Monash-BoSL/BoSL-nano/README.md

# micro-BoSL
A micro version of the BoSL board
