Monash-BoSL/BoSL-nano/Program-Conn/Program Connector BOM Rev 0.1.0.xlsx

Part Number | Package Size / Type | Schematic Designator | Component | Value | QTY per board | Unit Price | Total Price | Supplier
 |  | J1 | 0.1" Pin Socket | 02x03 | 1 | $0.10 | $0.10
2430 |  | J2 | Pogo Pins |  | 6 | $0.49 | $2.97 | https://au.mouser.com/ProductDetail/Adafruit/2430/?qs=GURawfaeGuDsBQlXUxEF%252BA==
 |  |  | PCB | 0.8 mm Thinkness
