Monash-BoSL/BoSL-nano/nano/EDA/BoSLnano BOM Rev 0.1.0.xlsx

Part Number | Package Size / Type | Schematic Designator | Component | Value | QTY per board | Unit Price | Total Price | Supplier
146236-0011 |  | AE1 | NFC Antenna |  | 1 | $1.25 | $1.25 | https://au.mouser.com/ProductDetail/Molex/146236-0011/?qs=5aG0NVq1C4xhVsWJeZnAXw==
2337019-1 |  | AT1, AT2 | U.FL Antenna Connector |  | 2 | $0.34 | $0.68 | https://au.mouser.com/ProductDetail/TE-Connectivity/2337019-1
EMZR160ARA101ME61G | SMD:CP_Elec_5x5.8 | C1 | SMD Capacitor | 100 uF | 1 | $0.93 | $0.93 | https://au.mouser.com/ProductDetail/United-Chemi-Con/EMZR160ARA101ME61G?qs=y6ZabgHbY%252BxiK8n17fhUqw==
Any Applicable | 0805 | C2 | SMD Capacitor | 10 uF | 1 | $0.16 | $0.16 | https://au.mouser.com/ProductDetail/Samsung-Electro-Mechanics/CL21A106KPFNNNG/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
Any Applicable | 0402 | C3, C6, C7, C9, C10, C11, C12, C15, C18 | SMD Capacitor | 100 nF | 9 | $0.10 | $0.90
Any Applicable | 0402 | C4,C5,C13,C16 | SMD Capacitor | 15 pF | 4 | $0.10 | $0.40
Any Applicable | 0402 | C8,C14 | SMD Capacitor | 1 uF | 2 | $0.10 | $0.20
Any Applicable | 0402 | C17 | SMD Capacitor | 220 pF | 1 | $0.10 | $0.10
Any Applicable | 0402 | C19 | SMD Capacitor | 1 nF | 1 | $0.10 | $0.10
PMEG2005EL,315 | SOD882 | D1 | Schottky Diode |  | 1 | $0.46 | $0.46 | https://au.mouser.com/ProductDetail/Nexperia/PMEG2005EL315?qs=LOCUfHb8d9uUSLf2%252Btg0Cg==
Any Applicable | 0603 | D2 | SMD LED | BLUE | 1 | $0.10 | $0.10
Any Applicable | 0603 | D3 | SMD LED | RED | 1 | $0.10 | $0.10
Any Applicable | 0603 | D4 | SMD LED | YELLOW | 1 | $0.10 | $0.10
Any Applicable | 0603 | D5 | SMD LED | GREEN | 1 | $0.10 | $0.10
104031-0811 Molex |  | J1 | microSD connector |  | 1 | $2.50 | $2.50 | https://au.mouser.com/ProductDetail/Molex/104031-0811?qs=sGAEpiMZZMuJakaoiLiBpj1mGp1aVlb8QxJnovvyiw8%3D
S2B-PH-SM4-TB(LF)(SN) | JST PH | J8 | Power Connector | 2 pin | 1 | $0.98 | $0.98 | https://au.element14.com/jst-japan-solderless-terminals/s2b-ph-sm4-tb-lf-sn/connector-header-smt-r-a-2mm-2way/dp/9492615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
SIM Card Holder | Nano SIM | J9 | SIM Card Holder |  | 1 | $1.50 | $1.50 | https://au.mouser.com/ProductDetail/Molex/104224-0820
105133-0001 | Micro | J10 | Micro USB Connector | Vertical | 1 | $1.46 | $1.46 | https://au.element14.com/molex/105133-0001/usb-conn-2-0-micro-usb-type-b/dp/2751682?st=micro usb
MLG0603P9N1HT000 | 0603 | L1 | Inductor | 9.1 nH | 1 | $0.15 | $0.15 | https://au.mouser.com/ProductDetail/TDK/MLG0603P9N1HT000/?qs=u4%252BEJ9urDAQc/lR37YK7mA==
Any Applicable | 0402 | R1,R2 | SMD Resistor | 1 kΩ | 2 | $0.10 | $0.20
Any Applicable | 0402 | R3,R5,R6 | SMD Resistor | 39 Ω | 3 | $0.10 | $0.30
Any Applicable | 0402 | R4 | SMD Resistor | 100 kΩ | 1 | $0.10 | $0.10
Any Applicable | 0402 | R7, R8, R12, R17 | SMD Resistor | 10 kΩ | 4 | $0.10 | $0.40
Any Applicable | 0402 | R9, R14, R15, R16 | SMD Resistor | 3.3 kΩ | 4 | $0.10 | $0.40
Any Applicable | 0402 | R10 | SMD Resistor | 12 MΩ | 1 | $0.10 | $0.10
Any Applicable | 0402 | R11 | SMD Resistor | 3.3 MΩ | 1 | $0.10 | $0.10
Any Applicable | 0402 | R13 | SMD Resistor | 18 kΩ | 1 | $0.10 | $0.10
SKTHAHE010 |  | SW1 | Tactile Switch |  | 1 | $0.87 | $0.87 | https://au.mouser.com/ProductDetail/Alps-Alpine/SKTHAHE010/?qs=T3oQrply3y8NYoSxPHM%252Buw==
MAX40203ANS | WLP-4 | U1,U2 | Ideal Diode |  | 2 | $0.93 | $1.86 | https://au.mouser.com/ProductDetail/Maxim-Integrated/MAX40203ANS%2bT
MCP1700T-3302E/TT | SOT-23 | U3 | Voltage Regulator |  | 1 | $0.54 | $0.54 | https://au.mouser.com/ProductDetail/Microchip-Technology/MCP1700T-3302E-TT/?qs=fM4xO01eazPmCNDrdHEdaw==
SAMD21G18A-MUT | QFN-48 | U4 | MCU |  | 1 | $4.44 | $4.44 | https://au.mouser.com/ProductDetail/Microchip-Technology-Atmel/ATSAMD21G18A-MUT/
NT3H2111W0FTTJ | TSSOP-8 | U5 | NFC Controller |  | 1 | $1.28 | $1.28 | https://au.mouser.com/ProductDetail/NXP-Semiconductors/NT3H2111W0FTTJ/?qs=5ptrxOxu%252BRZcycowRVRRqw==
nRF9160-SICA | SiP | U6 | LTE Modem |  | 1 | $33.80 | $33.80 | https://au.mouser.com/ProductDetail/Nordic-Semiconductor/nRF9160-SICA-R/?qs=PqoDHHvF648umA0p6bFBjQ==
BGA524N6E6327XTSA1 | TSNP-6 | U7 | GNSS LNA |  | 1 | $1.02 | $1.02 | https://au.mouser.com/ProductDetail/Infineon-Technologies/BGA524N6E6327XTSA1
MSQA6V1W5T2G | SOT-353 | U8 | ESD Protection Diodes |  | 1 | $0.54 | $0.54 | https://au.mouser.com/ProductDetail/ON-Semiconductor/MSQA6V1W5T2G/
FC-135 32.7680KA-AG5 |  | Y1 | Crystal | 32.768kHz | 1 | $0.43 | $0.43 | https://www.digikey.com.au/product-detail/en/epson/FC-135-32-7680KA-AG5/SER4271CT-ND/7932258
