Monash-BoSL/BoSL-nano/nano/EDA/BoSLnano Schematic rev0.1.0.pdf

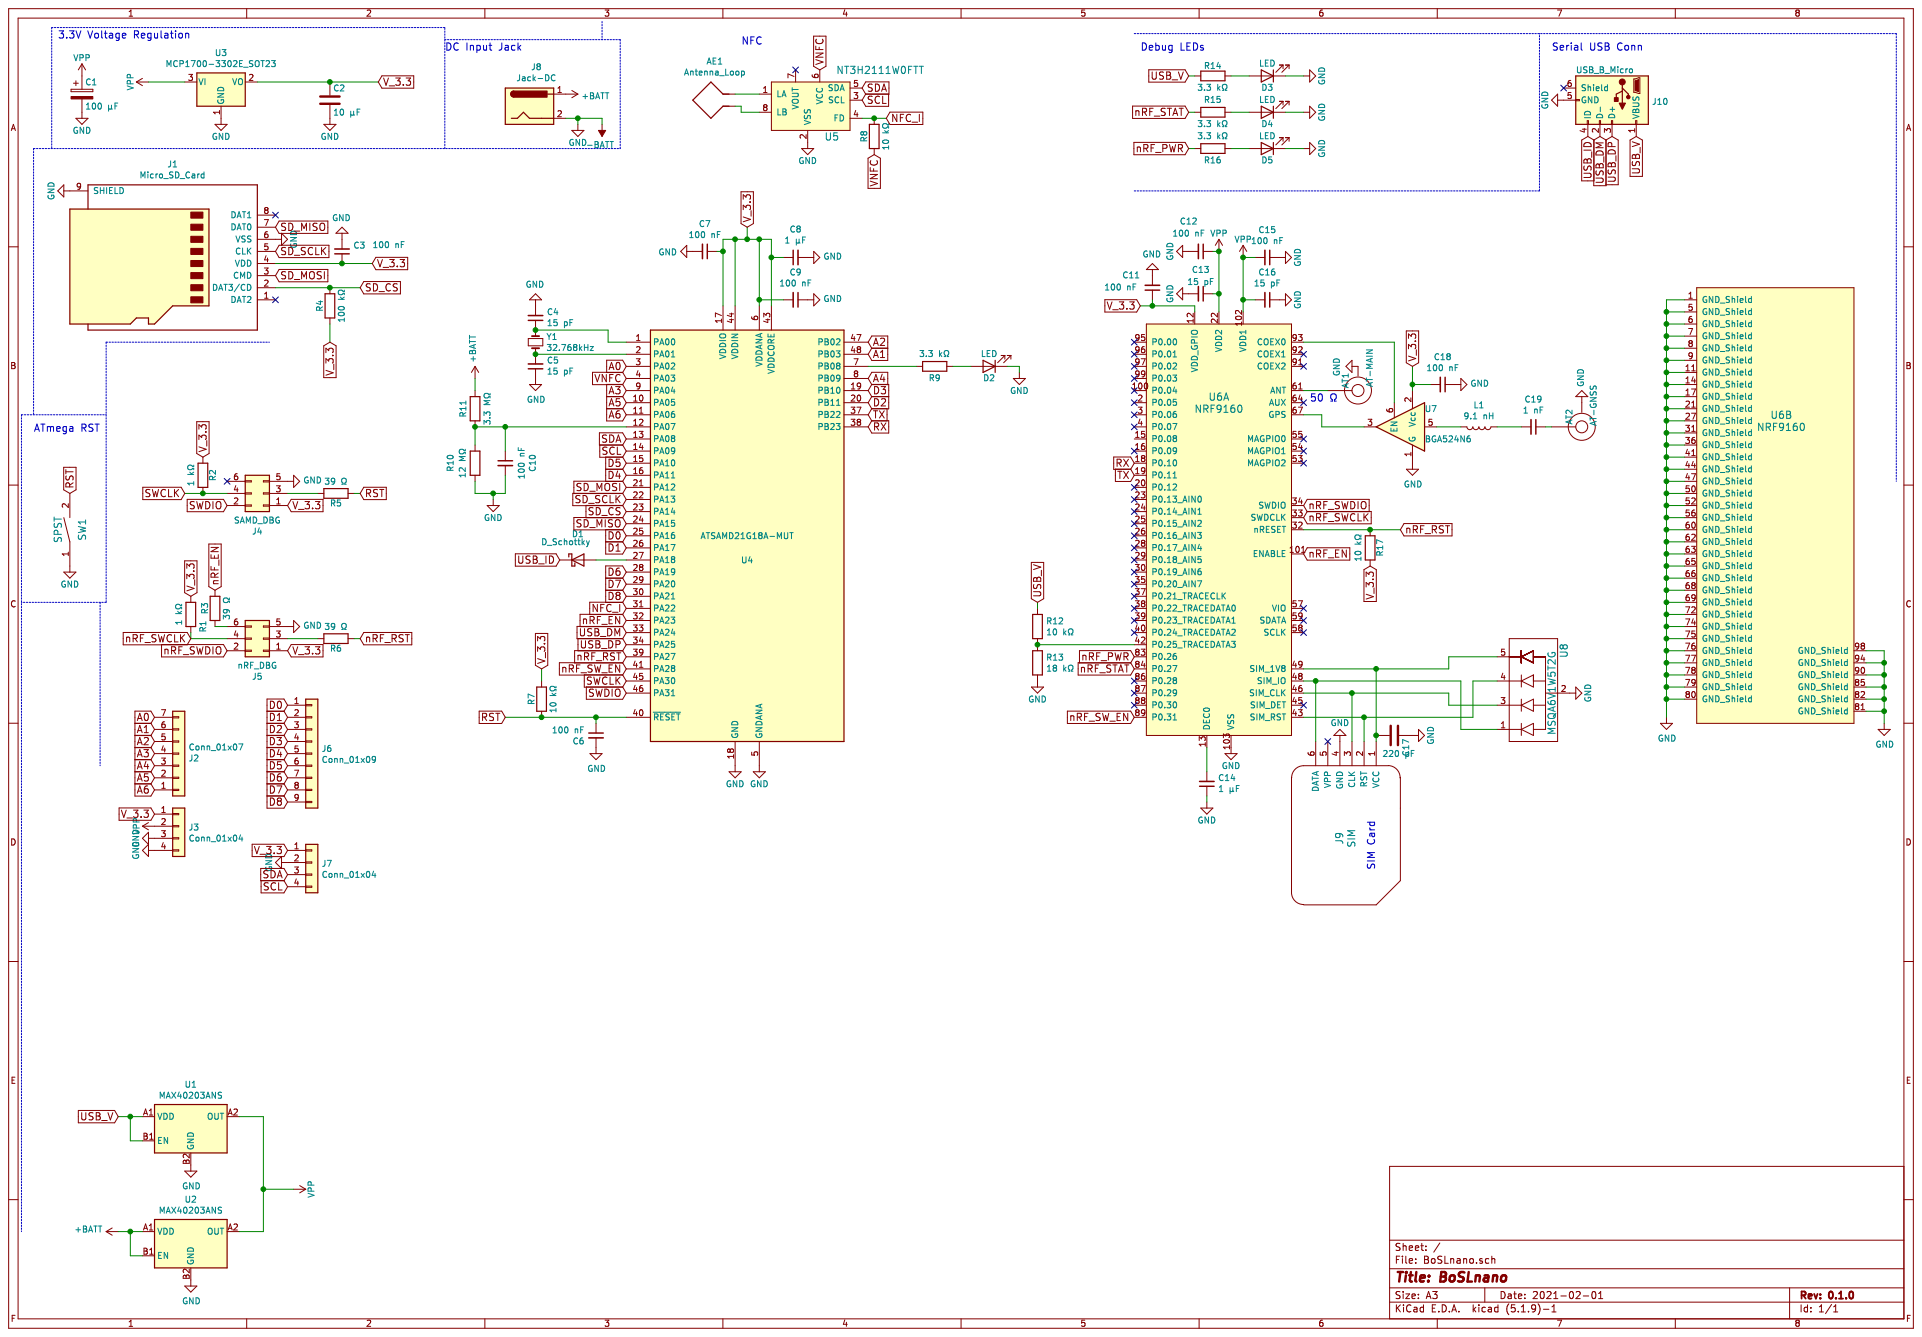
[picture p1: page 1]
