Monash-BoSL/BoSL-nano/(list of files, drawings)

Other design files:
nano/EDA/EDA/BoSLnano.dsn
