Monash-BoSL/BoSL-nano/nano/EDA/EDA/BoSLnano.kicad_pcb

## KiCad design nano/EDA/EDA/BoSLnano.kicad_pcb (2021-02-01)

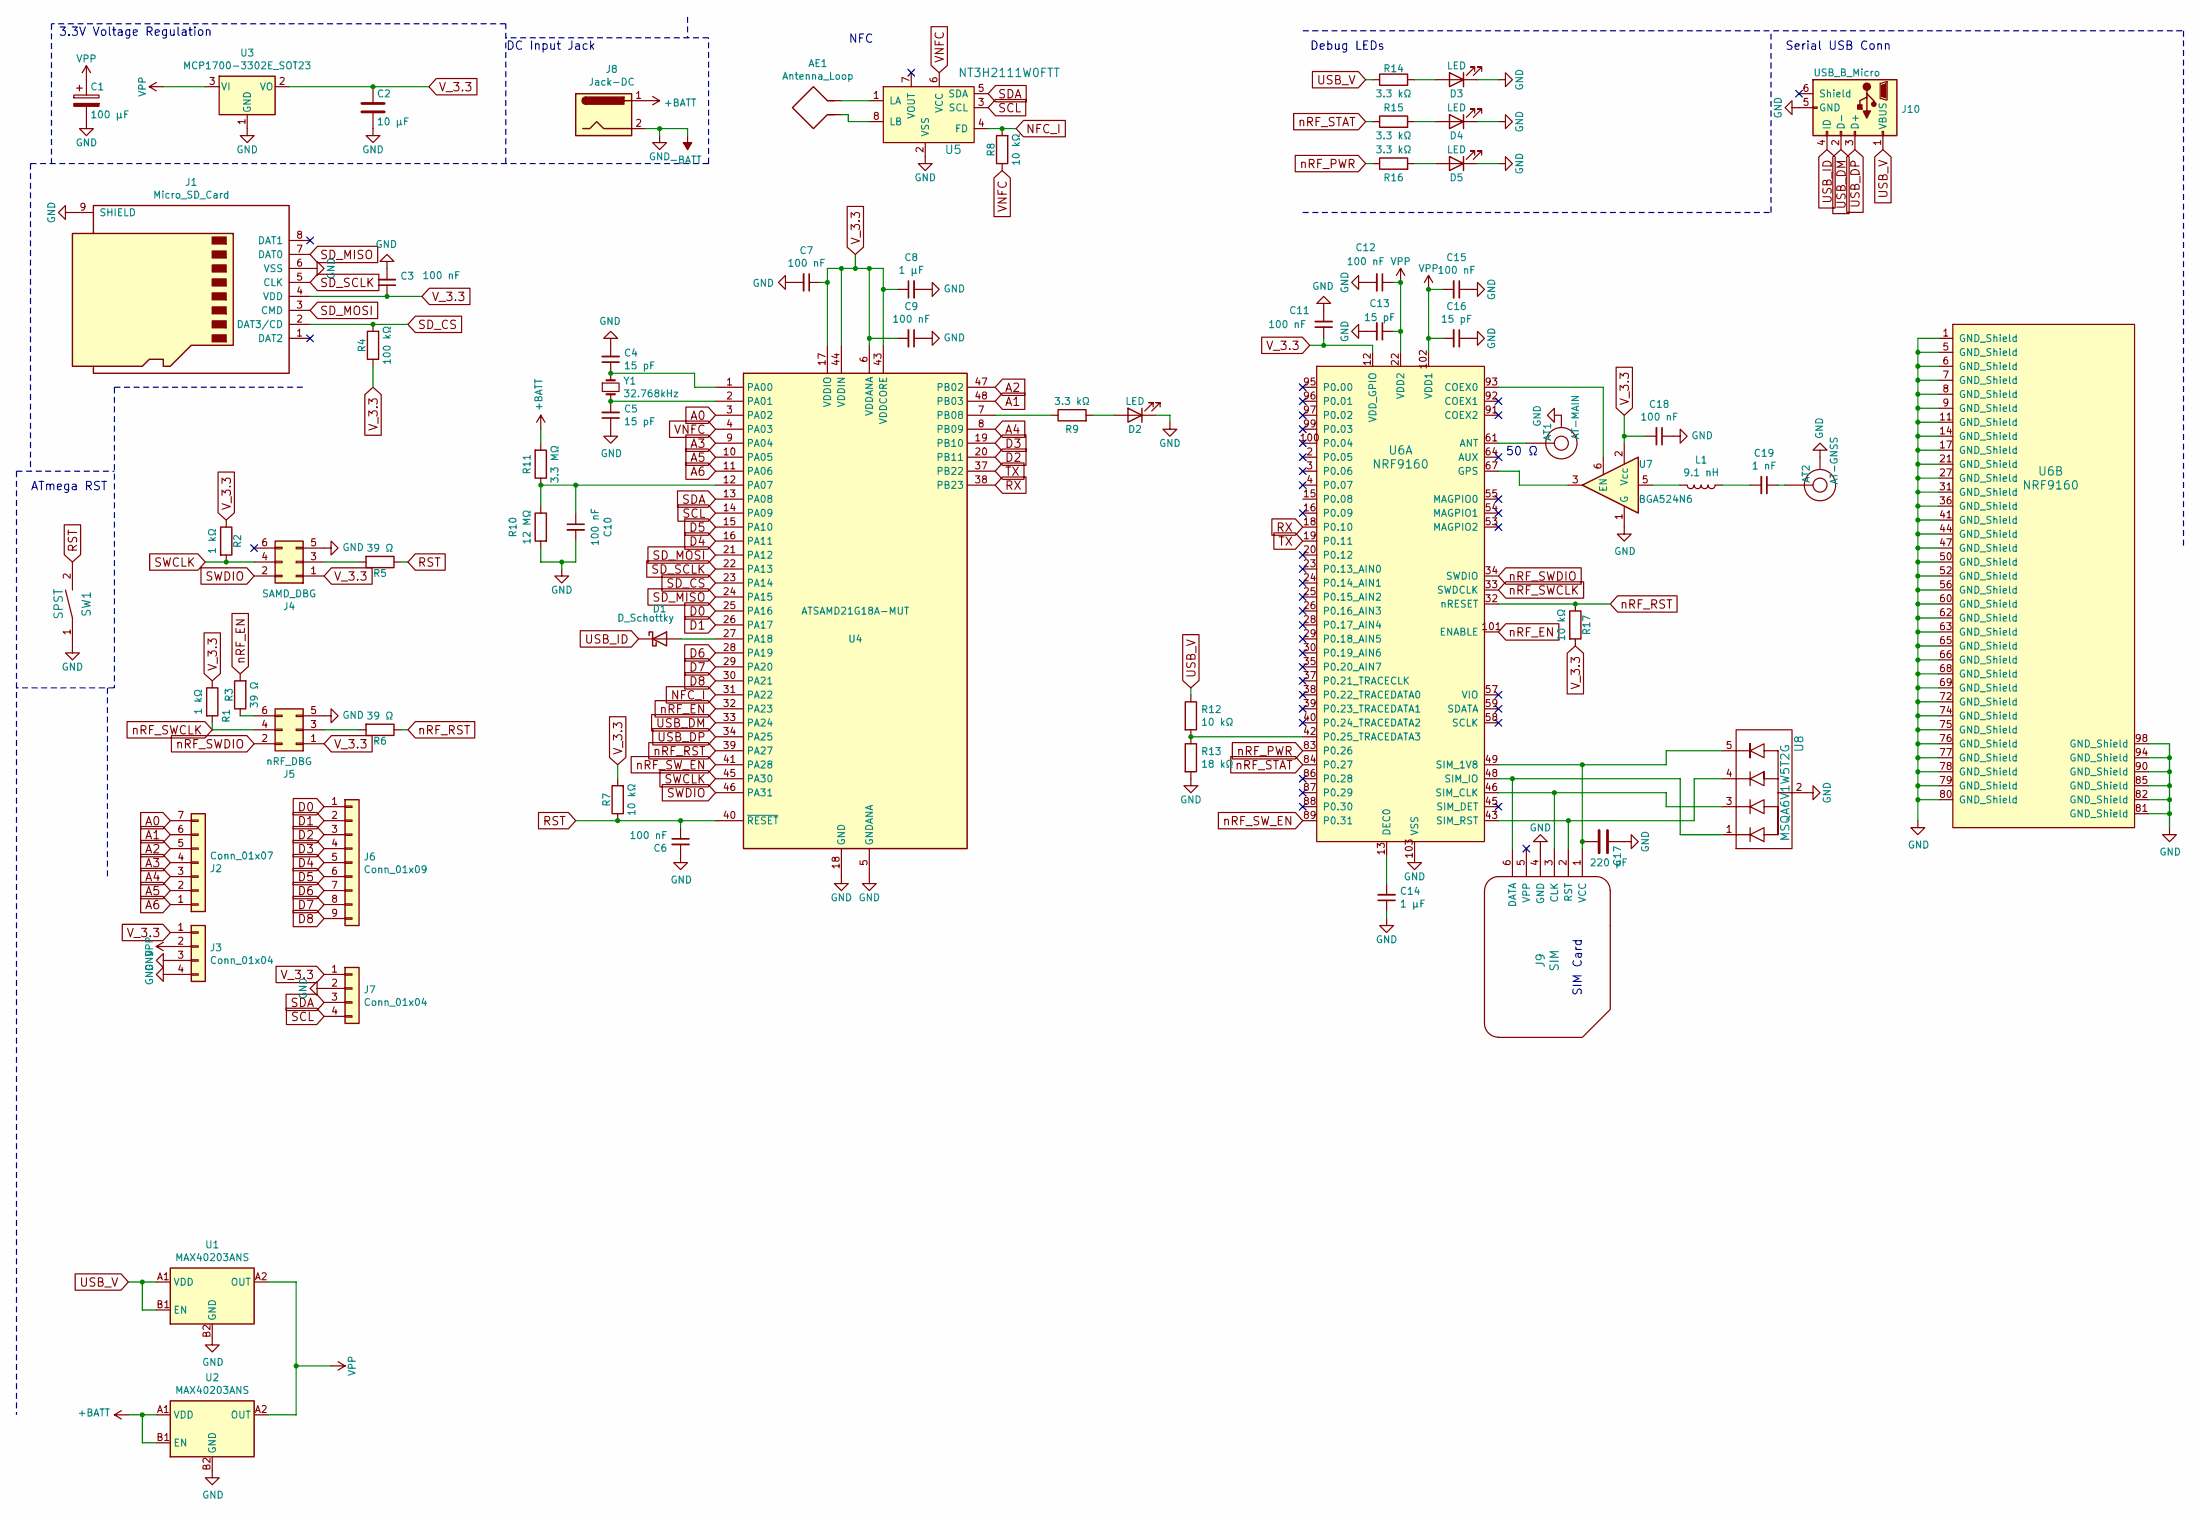
[picture p2: schematic BoSLnano.sch]

Parts:
AE1: Antenna_Loop; NFC antenna
AT1: AT-MAIN; U.FL_Molex_MCRF_73412-0110_Vertical
AT2: AT-GNSS; U.FL_Molex_MCRF_73412-0110_Vertical
C1: 100 μF; CP_Elec_5x5.8
C2: 10 μF; C_0805_2012Metric
C3, C6, C7, C9, C10, C11, C12, C15, C18: 100 nF; C_0402_1005Metric
C4, C5, C13, C16: 15 pF; C_0402_1005Metric
C8, C14: 1 μF; C_0402_1005Metric
C17: 220 pF; C_0402_1005Metric
C19: 1 nF; C_0402_1005Metric
D1: D_Schottky; SOD882
D2, D3, D4, D5: LED; LED_0603_1608Metric
J1: Micro_SD_Card; microSD_Connector
J2: Conn_01x07; PinHeader_1x07_P2.54mm_Vertical
J3, J7: Conn_01x04; PinHeader_1x04_P2.54mm_Vertical
J4: SAMD_DBG; TC2030_Pinless
J5: nRF_DBG; TC2030_Pinless
J6: Conn_01x09; PinHeader_1x09_P1.27mm_Vertical
J8: Jack-DC; JST_PH_S2B-PH-SM4-TB_1x02-1MP_P2.00mm_Horizontal
J9: SIM; SIMNano
J10: USB_B_Micro; USB_Micro-B_Molex-105133-0001
L1: 9.1 nH; L_0603_1608Metric
R1, R2: 1 kΩ; R_0402_1005Metric
R3, R5, R6: 39 Ω; R_0402_1005Metric
R4: 100 kΩ; R_0402_1005Metric
R7, R8, R12, R17: 10 kΩ; R_0402_1005Metric
R9, R14, R15, R16: 3.3 kΩ; R_0402_1005Metric
R10: 12 MΩ; R_0402_1005Metric
R11: 3.3 MΩ; R_0402_1005Metric
R13: 18 kΩ; R_0402_1005Metric
SW1: SPST; SW_Push_SPST_NO_Alps_SKRK
U1, U2: MAX40203ANS; WLP-4_0.73x0.73mm_Layout2x2_P0.35mm_Ball0.22mm_Pad0.2mm_NSMD
U3: MCP1700-3302E_SOT23; SOT-23
U4: ATSAMD21G18A-MUT; QFN-48-1EP_7x7mm_P0.5mm_EP5.15x5.15mm
U5: NT3H2111W0FTT; TSSOP-8_3x3mm_P0.65mm
U6: NRF9160; nRF9160
U7: BGA524N6; TSNP-6-2
U8: MSQA6V1W5T2G; SOT-353_SC-70-5
Y1: 32.768kHz; Crystal_SMD_EuroQuartz_EQ161-2Pin_3.2x1.5mm

Connections:
+BATT: J8.1, R11.2, U2.A1 (VDD), U2.B1 (EN)
-BATT: AT1.2, AT2.2, C1.2, C2.2, C3.2, C4.2, C5.1, C6.2, C7.2, C8.2, C9.1, C10.2, C11.2, C12.2, C13.2, C14.1, C15.1, C16.1, C17.1, C18.1, D2.1 (K), D3.1 (K), D4.1 (K), D5.1 (K), J1.6 (VSS), J1.9 (SHIELD), J3.3, J3.4, J4.5, J5.5, J7.2, J8.2, J9.4 (GND), J10.5 (GND), R10.2, R13.2, SW1.1, U1.B2 (GND), U2.B2 (GND), U3.1 (GND), U4.5 (GNDANA), U4.18 (GND), U4.35 (GND), U4.42 (GND), U4.49, U5.2 (VSS), U6.1 (GND_Shield), U6.5 (GND_Shield), U6.6 (GND_Shield), U6.7 (GND_Shield), U6.8 (GND_Shield), U6.9 (GND_Shield), U6.11 (GND_Shield), U6.14 (GND_Shield), U6.17 (GND_Shield), U6.21 (GND_Shield), U6.27 (GND_Shield), U6.31 (GND_Shield), U6.36 (GND_Shield), U6.41 (GND_Shield), U6.44 (GND_Shield), U6.47 (GND_Shield), U6.50 (GND_Shield), U6.52 (GND_Shield), U6.56 (GND_Shield), U6.60 (GND_Shield), U6.62 (GND_Shield), U6.63 (GND_Shield), U6.65 (GND_Shield), U6.66 (GND_Shield), U6.68 (GND_Shield), U6.69 (GND_Shield), U6.72 (GND_Shield), U6.74 (GND_Shield), U6.75 (GND_Shield), U6.76 (GND_Shield), U6.77 (GND_Shield), U6.78 (GND_Shield), U6.79 (GND_Shield), U6.80 (GND_Shield), U6.81 (GND_Shield), U6.82 (GND_Shield), U6.85 (GND_Shield), U6.90 (GND_Shield), U6.94 (GND_Shield), U6.98 (GND_Shield), U6.103 (VSS), U7.1 (G), U7.4 (G), U8.2
A0: J2.7, U4.3 (PA02)
A1: J2.6, U4.48 (PB03)
A2: J2.5, U4.47 (PB02)
A3: J2.4, U4.9 (PA04)
A4: J2.3, U4.8 (PB09)
A5: J2.2, U4.10 (PA05)
A6: J2.1, U4.11 (PA06)
D0: J6.1, U4.25 (PA16)
D1: J6.2, U4.26 (PA17)
D2: J6.3, U4.20 (PB11)
D3: J6.4, U4.19 (PB10)
D4: J6.5, U4.16 (PA11)
D5: J6.6, U4.15 (PA10)
D6: J6.7, U4.28 (PA19)
D7: J6.8, U4.29 (PA20)
D8: J6.9, U4.30 (PA21)
NFC_I: R8.2, U4.31 (PA22), U5.4 (FD)
unnamed: AE1.1, U5.8 (LB)
unnamed: AE1.2, U5.1 (LA)
unnamed: AT1.1, U6.61 (ANT)
unnamed: AT2.1, C19.1
unnamed: C4.1, U4.1 (PA00), Y1.1
unnamed: C5.2, U4.2 (PA01), Y1.2
unnamed: C10.1, R10.1, R11.1, U4.12 (PA07)
unnamed: C14.2, U6.13 (DEC0)
unnamed: C17.2, J9.1 (VCC), U6.49 (SIM_1V8), U8.5
unnamed: C19.2, L1.1
unnamed: D1.2 (A), U4.27 (PA18)
unnamed: D2.2 (A), R9.2
unnamed: D3.2 (A), R14.2
unnamed: D4.2 (A), R15.2
unnamed: D5.2 (A), R16.2
unnamed: J4.3, R5.2
unnamed: J5.3, R6.2
unnamed: J5.6, R3.1
unnamed: J9.2 (RST), U6.43 (SIM_RST), U8.4
unnamed: J9.3 (CLK), U6.46 (SIM_CLK), U8.3
unnamed: J9.6 (DATA), U6.48 (SIM_IO), U8.1
unnamed: L1.2, U7.5
unnamed: R9.1, U4.7 (PB08)
unnamed: R12.2, R13.1, U6.42 (P0.25_TRACEDATA3)
unnamed: U6.67 (GPS), U7.3
unnamed: U6.93 (COEX0), U7.6 (EN)
RST: C6.1, R5.1, R7.1, SW1.2, U4.40 (~RESET)
RX: U4.38 (PB23), U6.18 (P0.10)
SCL: J7.4, U4.14 (PA09), U5.3 (SCL)
SDA: J7.3, U4.13 (PA08), U5.5 (SDA)
SD_CS: J1.2 (DAT3/CD), R4.2, U4.23 (PA14)
SD_MISO: J1.7 (DAT0), U4.24 (PA15)
SD_MOSI: J1.3 (CMD), U4.21 (PA12)
SD_SCLK: J1.5 (CLK), U4.22 (PA13)
SWCLK: J4.4, R2.2, U4.45 (PA30)
SWDIO: J4.2, U4.46 (PA31)
TX: U4.37 (PB22), U6.19 (P0.11)
USB_DM: J10.2 (D-), U4.33 (PA24)
USB_DP: J10.3 (D+), U4.34 (PA25)
USB_ID: D1.1 (K), J10.4 (ID)
USB_V: J10.1 (VBUS), R12.1, R14.1, U1.A1 (VDD), U1.B1 (EN)
VNFC: R8.1, U4.4 (PA03), U5.6 (VCC)
VPP: C1.1, C12.1, C13.1, C15.2, C16.2, J3.2, U1.A2 (OUT), U2.A2 (OUT), U3.3 (VI), U6.22 (VDD2), U6.102 (VDD1)
V_3.3: C2.1, C3.1, C7.1, C8.1, C9.2, C11.1, C18.2, J1.4 (VDD), J3.1, J4.1, J5.1, J7.1, R1.1, R2.1, R4.1, R7.2, R17.2, U3.2 (VO), U4.6 (VDDANA), U4.17 (VDDIO), U4.36 (VDDIO), U4.43 (VDDCORE), U4.44 (VDDIN), U6.12 (VDD_GPIO), U7.2 (Vcc)
nRF_EN: R3.2, U4.32 (PA23), U6.101 (ENABLE)
nRF_PWR: R16.1, U6.83 (P0.26)
nRF_RST: R6.1, R17.1, U4.39 (PA27), U6.32 (nRESET)
nRF_STAT: R15.1, U6.84 (P0.27)
nRF_SWCLK: J5.4, R1.2, U6.33 (SWDCLK)
nRF_SWDIO: J5.2, U6.34 (SWDIO)
nRF_SW_EN: U4.41 (PA28), U6.89 (P0.31)

Notes on the sheet:
3.3V Voltage Regulation
DC Input Jack
SIM Card
Debug LEDs
NFC
Serial USB Conn
50 Ω
ATmega RST

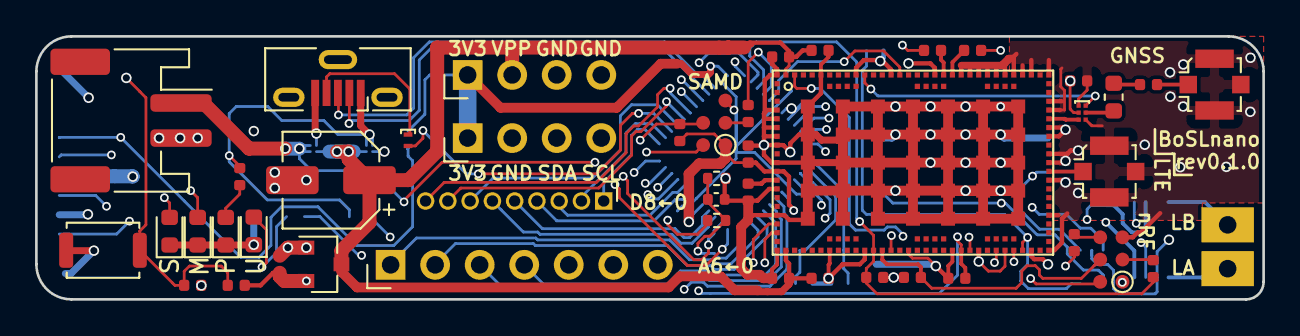
[picture p3: board BoSLnano.kicad_pcb from above]

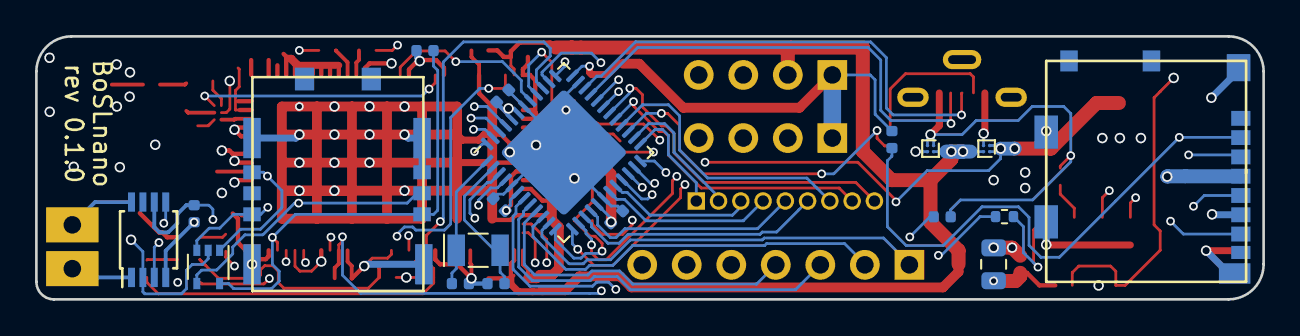
[picture p4: board BoSLnano.kicad_pcb from below]

Board: 4 copper layers, 70.0 x 15.0 mm, 65 parts (19 on the bottom side), 70 nets.
