Monash-BoSL/BoSL-nano/(commit log)

2020-12-02 addded BoSL files
    [microBoSL BOM Rev 0.1.0.xlsx, microBoSL.dsn, microBoSL.kicad_pcb, microBoSL.sch]
2020-12-02 chnaged a few packages arround
    [microBoSL.sch]
2020-12-03 added new footprints
    [microBoSL.kicad_pcb, microBoSL.sch]
2020-12-04 preliminary layout
    [microBoSL.dsn, microBoSL.kicad_pcb, microBoSL.sch]
2020-12-07 finished layout of micro board
    [BoSLnano BOM Rev 0.1.0.xlsx, BoSLnano.dsn, BoSLnano.kicad_pcb, BoSLnano.sch, microBoSL BOM Rev 0.1.0.xlsx, microBoSL.dsn, microBoSL.kicad_pcb, microBoSL.sch]
2020-12-08 finished micro bosl design
    [BoSLnano BOM Rev 0.1.0.xlsx, microBoSL BOM Rev 0.1.0.xlsx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]
2020-12-08 changed some labled on microBoSL
    [microBoSL-B_Cu.gbl, microBoSL-B_Mask.gbs, microBoSL-B_SilkS.gbo, microBoSL-Edge_Cuts.gm1, microBoSL-F_Cu.gtl, microBoSL-F_Mask.gts, microBoSL-F_SilkS.gto, microBoSL.drl]
2021-01-19 finished bom and schematic - nano
    [BoSLnano BOM Rev 0.1.0.xlsx, BoSLnano.kicad_pcb, BoSLnano.sch, microBoSL BOM Rev 0.1.0.xlsx]
2021-01-21 added battery connector
    [BoSLnano BOM Rev 0.1.0.xlsx, BoSLnano.kicad_pcb, BoSLnano.sch]
2021-01-21 changed connectivity
    [BoSLnano.sch]
2021-01-27 modifed nano
    [BoSLnano BOM Rev 0.1.0.xlsx, BoSLnano.kicad_pcb, BoSLnano.sch]
2021-01-28 made to be 70 mm
    [BoSLnano.kicad_pcb]
2021-01-29 began routing nano
    [BoSLnano.kicad_pcb, BoSLnano.sch]
2021-02-01 finished PCB layout
    [BoSLnano BOM Rev 0.1.0.xlsx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]
2021-02-28 added hardware documentation
    [BoSLnano BOM Rev 0.1.0.xlsx, Program Connector BOM Rev 0.1.0.xlsx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]
2021-04-28 updated microbosl schematic
    [RTC Resistor Supply Calulations.xlsx, microBoSL BOM Rev 0.1.0.xlsx, microBoSL BOM Rev 0.2.0.xlsx, microBoSL.sch]
2021-04-29 worked on micro BOM
    [RTC Resistor Supply Calulations.xlsx, microBoSL BOM Rev 0.2.0.xlsx, microBoSL.sch]
2021-05-03 finished BOM
    [RTC Resistor Supply Calulations.xlsx, microBoSL BOM Rev 0.2.0.xlsx]
2021-05-03 microbosl layout finished TODO: optimise/silkscreen
    [microBoSL.kicad_pcb, microBoSL.sch]
2021-05-03 optimised tracing on micro
    [microBoSL.kicad_pcb]
2021-05-04 added silkscreen to microbosl
    [microBoSL.kicad_pcb]
2021-05-07 added 3 motors to the microBoSL in schematic and PCB, traces and silkscreen still need optimising
    [microBoSL BOM Rev 0.2.0.xlsx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]
2021-05-13 routed pcb with 4 hall effect sensors, TODO silkscreen
    [microBoSL BOM Rev 0.2.0.xlsx, microBoSL.kicad_pcb, microBoSL.sch]
2021-05-14 micro traces optimised and silkscreened TODO: panelisation
    [microBoSL.kicad_pcb]
2021-05-15 added panelisation and gerber for micro
    [microBoSL-B_Cu.gbl, microBoSL-B_Mask.gbs, microBoSL-B_SilkS.gbo, microBoSL-Edge_Cuts.gm1, microBoSL-F_Cu.gtl, microBoSL-F_Mask.gts, microBoSL-F_SilkS.gto, microBoSL-bottom-pos.csv]
2021-05-17 updated microBoSL panel with extra spacing
    [microBoSL-panel-B_Cu.gbr, microBoSL-panel-B_Mask.gbr, microBoSL-panel-B_Paste.gbr, microBoSL-panel-B_SilkS.gbr, microBoSL-panel-Cmts_User.gbr, microBoSL-panel-Edge_Cuts.gbr, microBoSL-panel-F_Cu.gbr, microBoSL-panel-F_Mask.gbr]
2021-05-19 modifed spacing on micro pcb panel
2021-06-24 fixed power switch on microBoSL added o-ring fix pinout
    [microBoSL BOM Rev 0.2.0.xlsx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]
2021-06-24 moved microBoSL to seperate repository
    [RTC Resistor Supply Calulations.xlsx, microBoSL.dsn, microBoSL.kicad_pcb, microBoSL.sch]
